hairymnstr/OmniWheel/omniwheel_60mm.FCStd

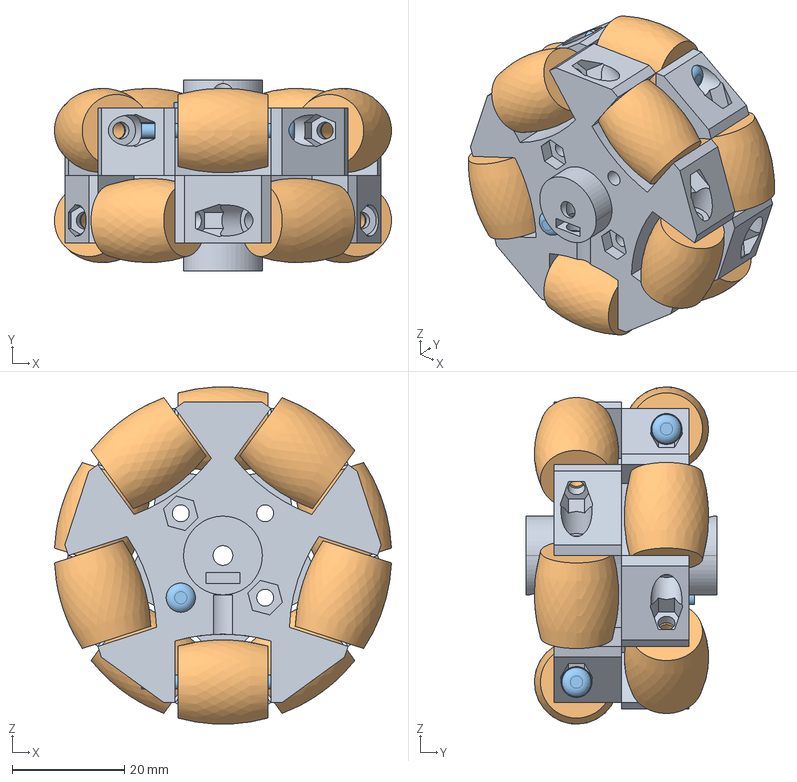
[picture p2: CAD file, 2024-05-04]
omniwheel_60mm.FCStd
59.9 x 34.0 x 59.9 mm
