hairymnstr/OmniWheel/60mm-omniwheel_v2Roller.stl

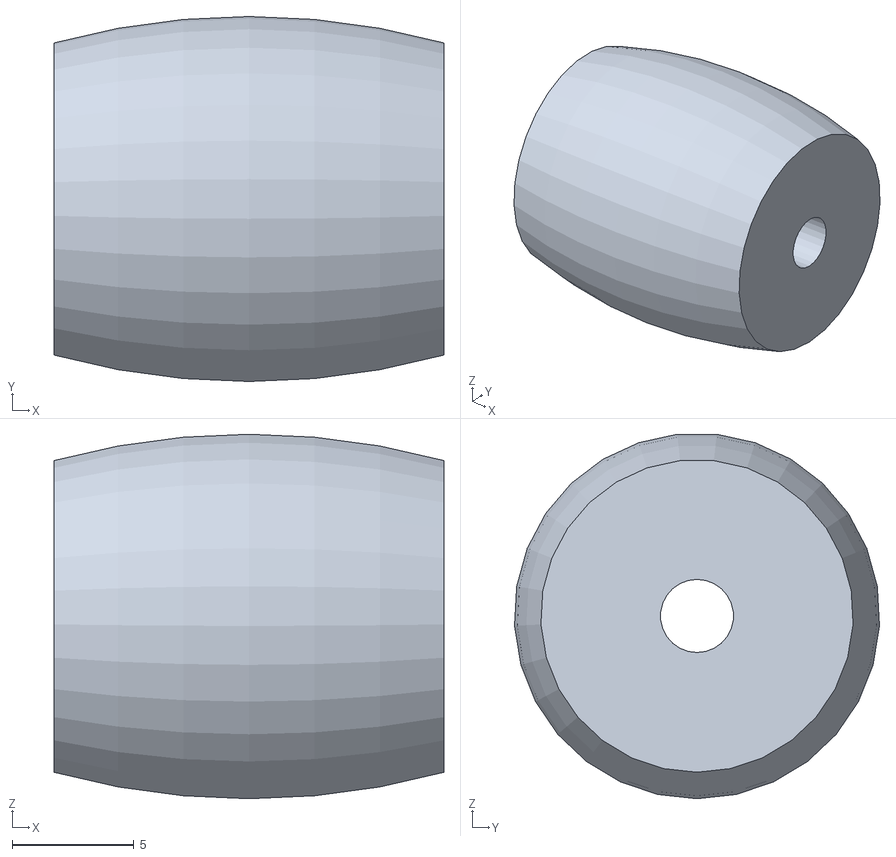
[picture p3: CAD file, 2024-05-04]
60mm-omniwheel_v2Roller.stl
16.0 x 15.0 x 15.0
