hairymnstr/OmniWheel/(commit log)

2024-04-13 Finished the model still needs printing and testing.
    [omniwheel_60mm.FCStd]
2024-05-04 Updated to detail the V2 design
    [60mm-omniwheel_v2Roller.stl, 60mm-omniwheel_v2hub.stl, omniwheel_60mm.FCStd]
2024-05-04 Final updates to the FreeCAD model
    [omniwheel_60mm.FCStd]
